NablaCheese505/analog-chaotic-multiscroll-oscillator/docs/ANALOGICOS-REPORTE_OSCILADOR_CAOTICO.pdf

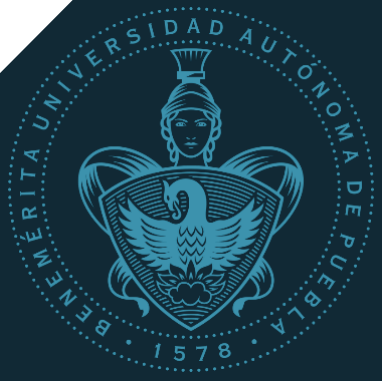
[picture p11: figure]
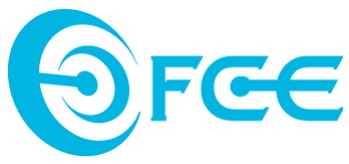
[picture p12: figure]

Facultad de Ciencias de la Electrónica Sistemas Analógicos y sus Aplicaciones Tabla conceptos
Alumnos:
- Carrasco Gómez Martin Farid
- Fructuoso Machuca Marco Antonio
- Jimenez Benitez Felix Arturo
- Vázquez Chanez Carlos Daniel Profesor:
Jesús Manuel Muñoz Pacheco Fecha de entrega:
25/05 Primavera 2025

# Reporte: Proyecto final

## Contenido

## Introducción

Los sistemas caóticos han sido ampliamente estudiados en la electrónica debido a su potencial en aplicaciones como comunicaciones seguras, generación de señales aleatorias y modelado de fenómenos no lineales. Entre ellos, los atractores multiscroll se destacan por su complejidad y capacidad de generar trayectorias caóticas con múltiples lóbulos (scrolls), dependiendo de la no linealidad introducida.
En esta práctica se implementó un atractor multiscroll en TopSpice, utilizando una arquitectura de tres integradores en cascada con realimentación negativa y una función no lineal basada en la hiperbólica tangente (tanh), realizada mediante un amplificador operacional con realimentación por diodo. Se estudió el efecto de los parámetros a, b, c y dᵢ sobre la dinámica del sistema, así como la importancia de la elección de componentes pasivos como capacitores y resistencias.

## Objetivos

### Objetivos generales

Diseñar, simular e implementar un sistema caótico multiscroll tipo Lu mediante amplificadores operacionales, verificando su comportamiento a través de simulaciones y pruebas experimentales.

### Objetivos específicos

- Analizar el sistema diferencial del tipo Lu y sus condiciones para generar atractores multiscroll.
- Determinar los valores de componentes pasivos que permitan implementar el sistema con coeficientes a = b = c = 0.7.
- Construir físicamente el circuito con amplificadores operacionales ideales y comprobar la generación del atractor.
- Observar el comportamiento del sistema real utilizando un osciloscopio y comparar los resultados con la simulación.

## Desarrollo

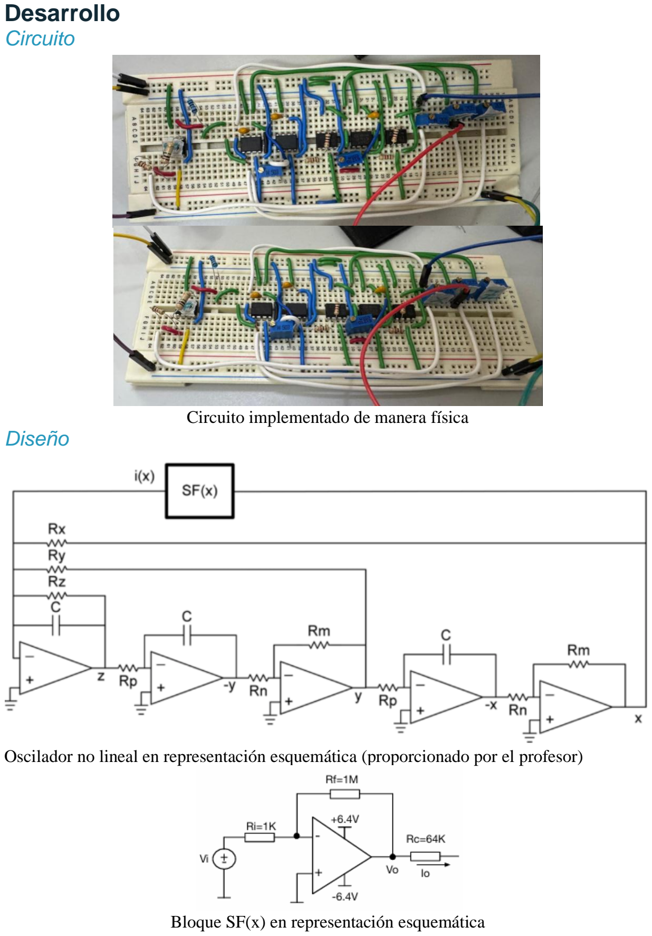
[picture p13: page 4]

### Circuito

Circuito implementado de manera física

### Diseño

Oscilador no lineal en representación esquemática (proporcionado por el profesor)

Bloque SF(x) en representación esquemática

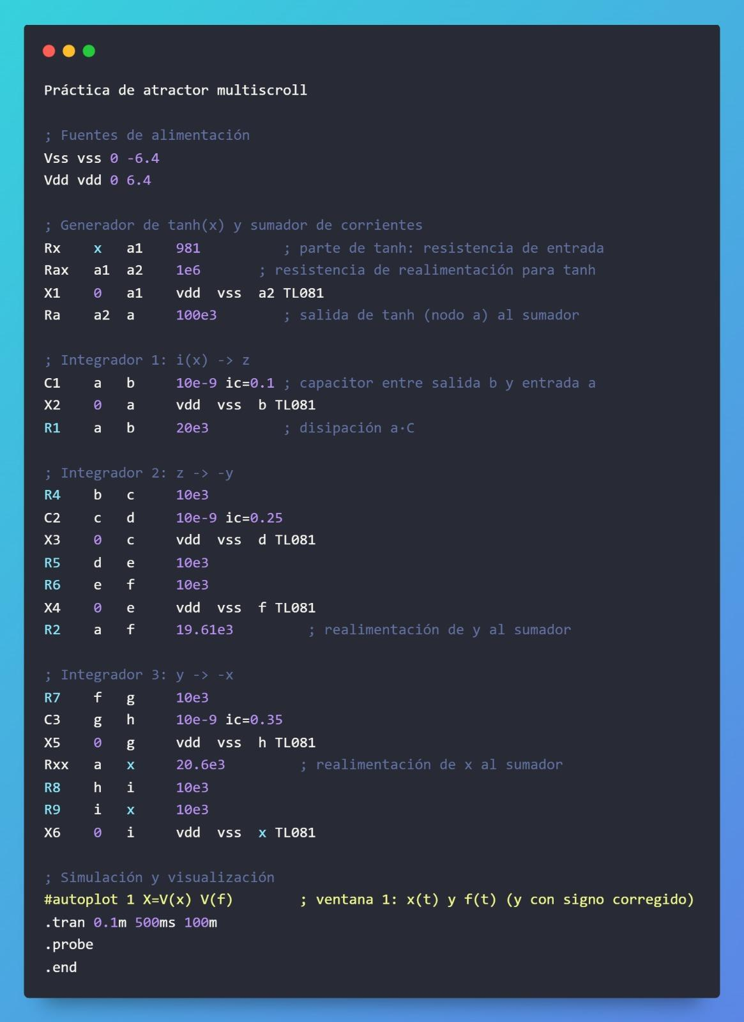
[picture p14: figure]

### Código SPICE

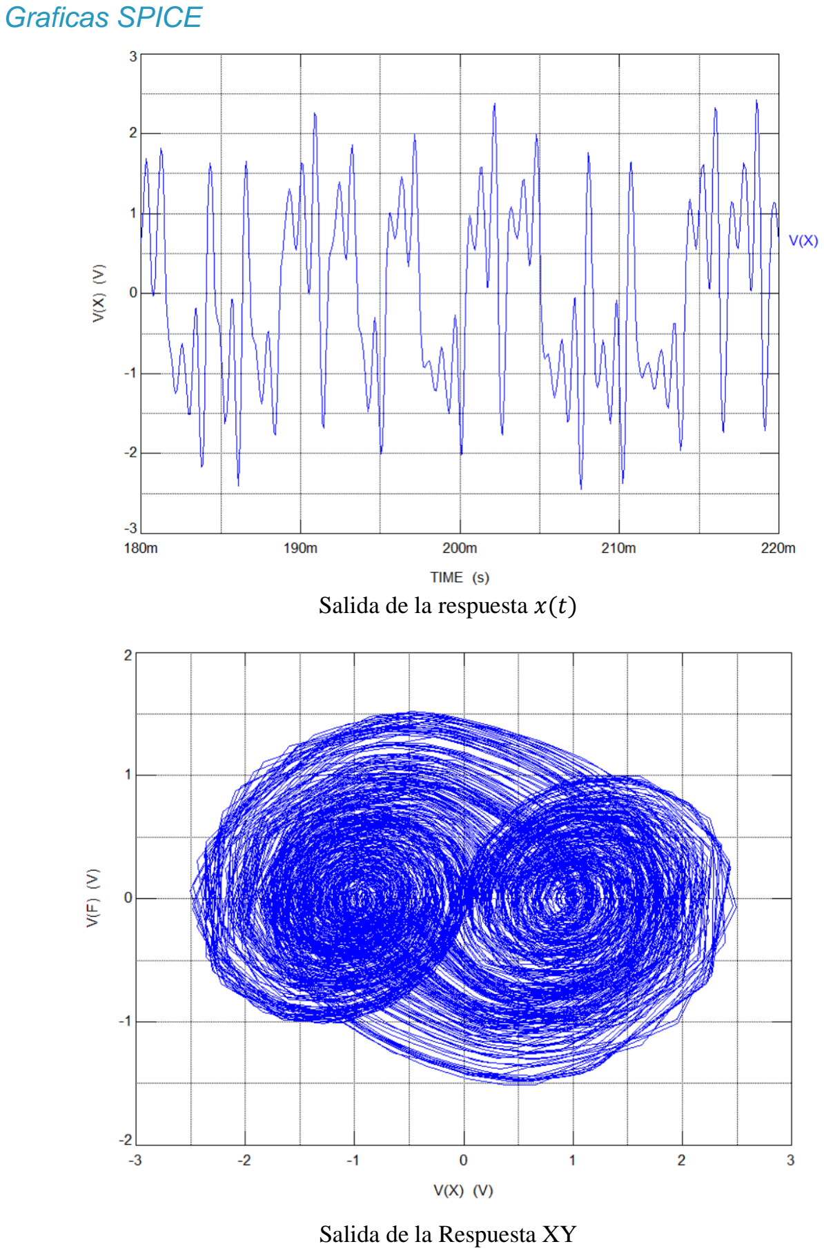
[picture p15: page 6]

### Graficas SPICE

Salida de la respuesta x(t)

Salida de la Respuesta XY

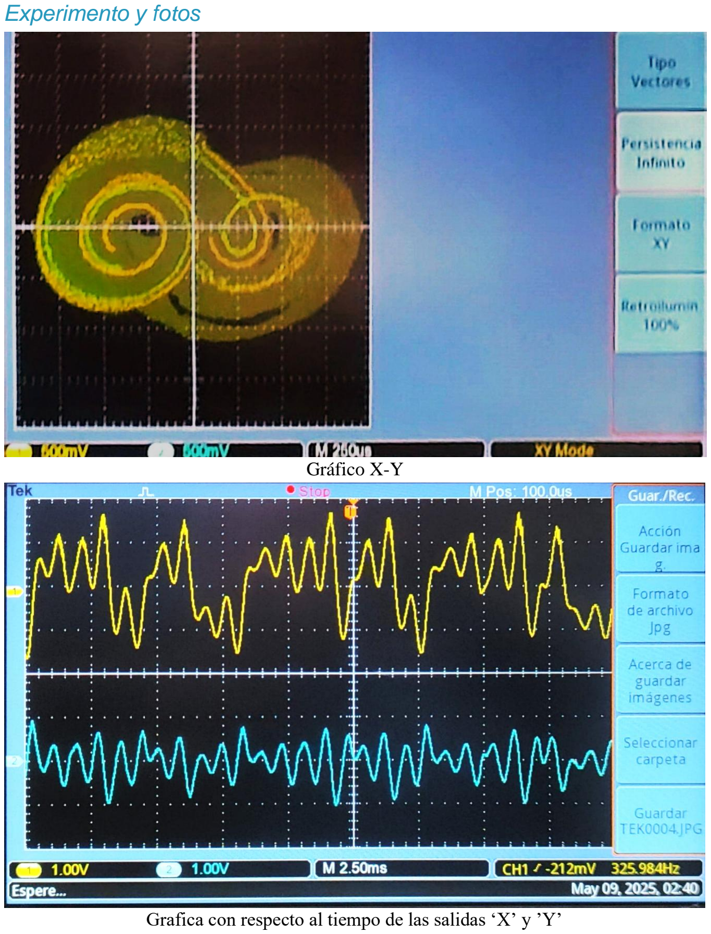
[picture p16: page 7]

### Experimento y fotos

Gráfico X-Y

Grafica con respecto al tiempo de las salidas ‘X’ y ’Y’

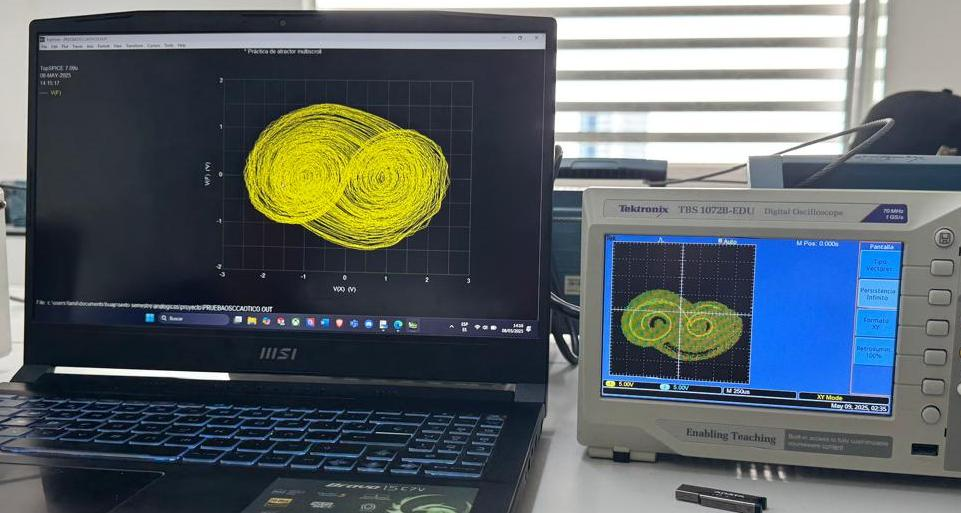
[picture p17: figure]

Gráfico X-Y en osciloscopio (prueba real a la derecha), grafico X-Y en computadora (simulación SPICE a la izquierda)

## Conclusiones

Se logró diseñar e implementar un oscilador multiscroll funcional, capaz de generar atractores caóticos bajo condiciones adecuadas de diseño. Las simulaciones en TopSpice permitieron predecir correctamente el comportamiento del sistema. A través del ajuste del parámetro d_i y la correcta selección de resistencias y capacitores, se generaron múltiples scrolls en el espacio de fases.
La implementación física confirmó los resultados teóricos y simulados. Usando un osciloscopio se observaron las trayectorias esperadas, validando que el sistema analógico reproduce correctamente la dinámica caótica prevista. Se demostró que es posible construir sistemas caóticos multiscroll con componentes electrónicos comunes y principios de amplificación operacional.

## Referencias

1. Lu, J. & Chen, G. (2004). Generating Multiscroll Chaotic Attractors: Theories, Methods and Applications. International Journal of Bifurcation and Chaos.
2. Ogorzalek, M. J. (1993). Chaos and Complexity in Nonlinear Electronic Circuits. World Scientific.
3. TopSpice User Manual – Penzar Development.
4. Notas de clase – Sistemas Analógicos y sus Aplicaciones (PhD Jesús M. Muñoz Pacheco).
