NablaCheese505/analog-chaotic-multiscroll-oscillator/media/XY_2.gif

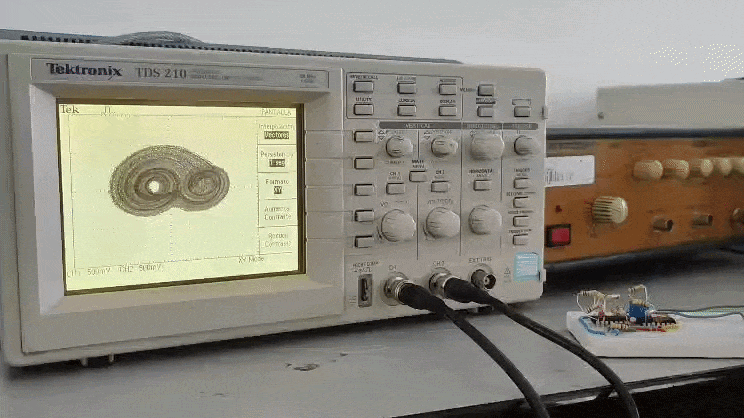
media/XY_2.gif
